Siddhartha-1234/ADC-Analog-Design-ASIC/README.md

# Flash ADC in XSCHEM
* LvtNot -  Inverter which works on low voltage nmos and pmos
* OneHotMux - If else statement or MUX switch
