Siddhartha-1234/ADC-Analog-Design-ASIC/cdac3_v1.png

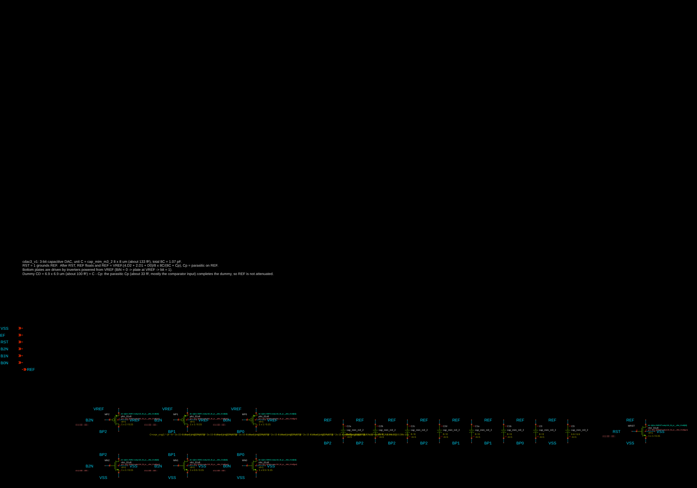
cdac3_v1.png
