Siddhartha-1234/ADC-Analog-Design-ASIC/cdac_vcm3.png

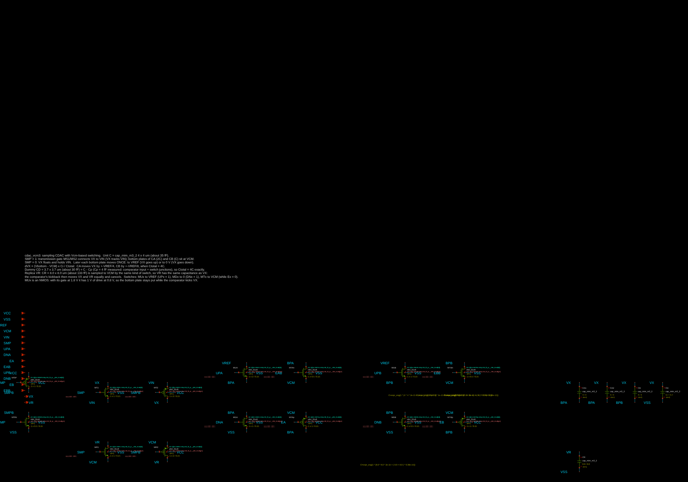
cdac_vcm3.png
