Siddhartha-1234/ADC-Analog-Design-ASIC/inv_min.png

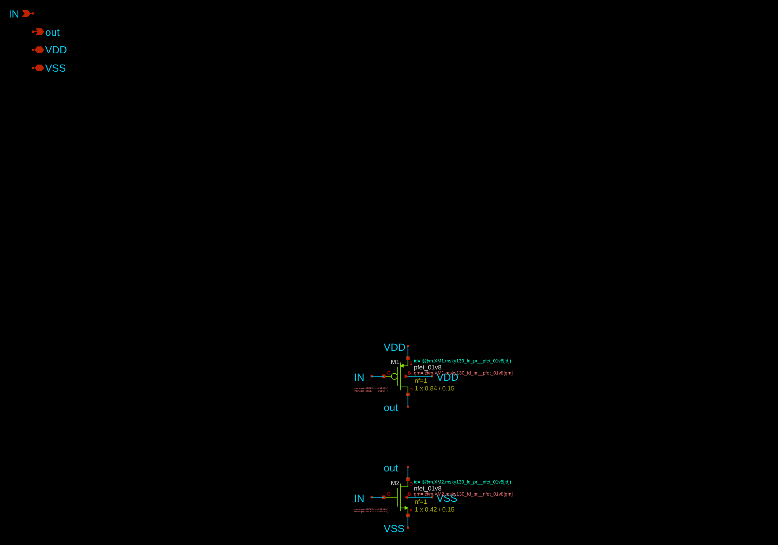
inv_min.png
