Siddhartha-1234/ADC-Analog-Design-ASIC/latch_comp.png

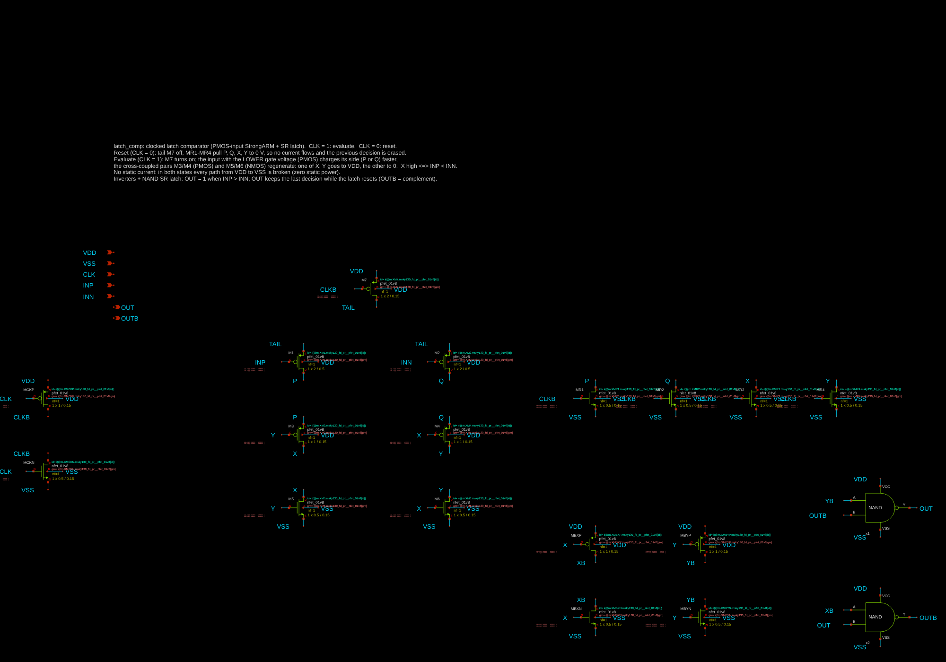
latch_comp.png
