Siddhartha-1234/ADC-Analog-Design-ASIC/nor2_min.png

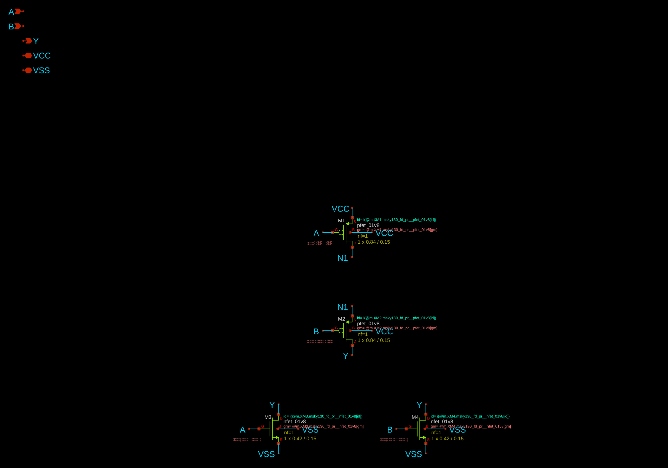
nor2_min.png
