Siddhartha-1234/ADC-Analog-Design-ASIC/sar_adc3_v1.png

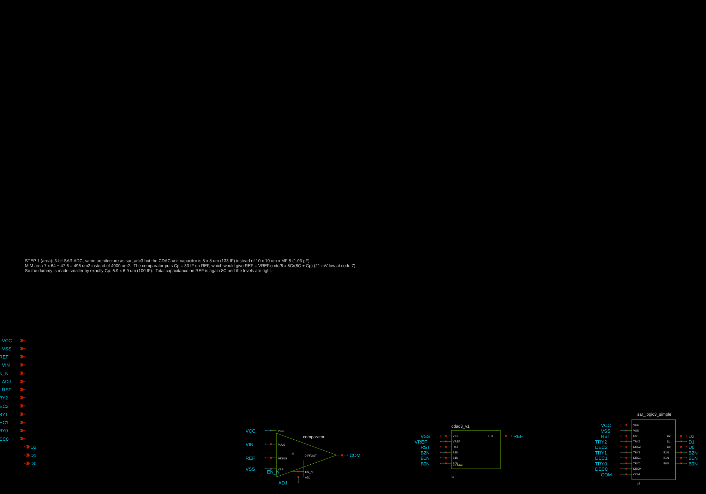
sar_adc3_v1.png
