Siddhartha-1234/ADC-Analog-Design-ASIC/SAR_improved/ramp_dnl_inl/sar_improved_dnl_inl.png

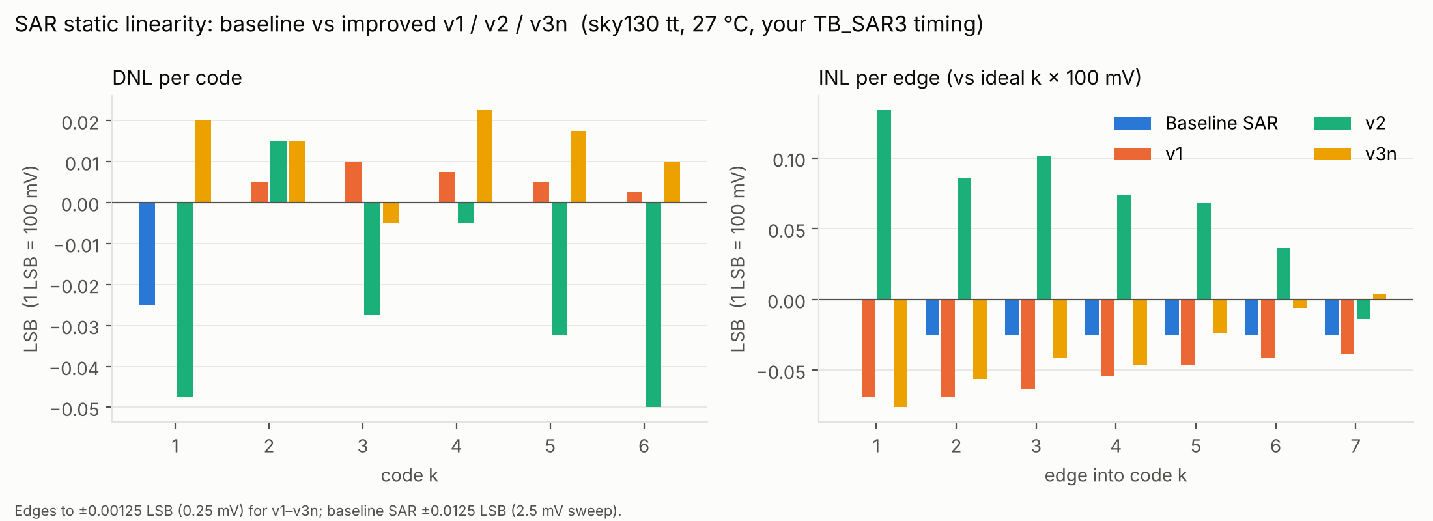
SAR_improved/ramp_dnl_inl/sar_improved_dnl_inl.png
