Siddhartha-1234/ADC-Analog-Design-ASIC/sar_logic_vcm3.png

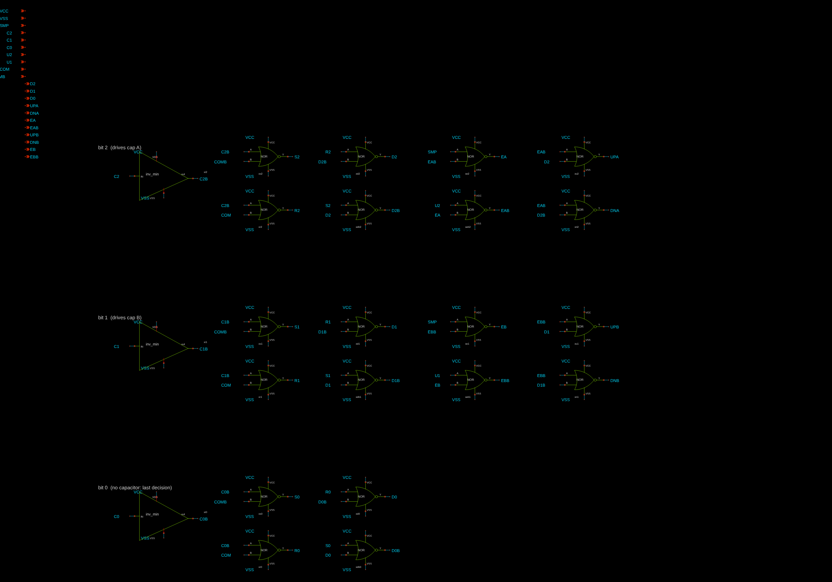
sar_logic_vcm3.png
