Siddhartha-1234/ADC-Analog-Design-ASIC/TB_latch_comp.png

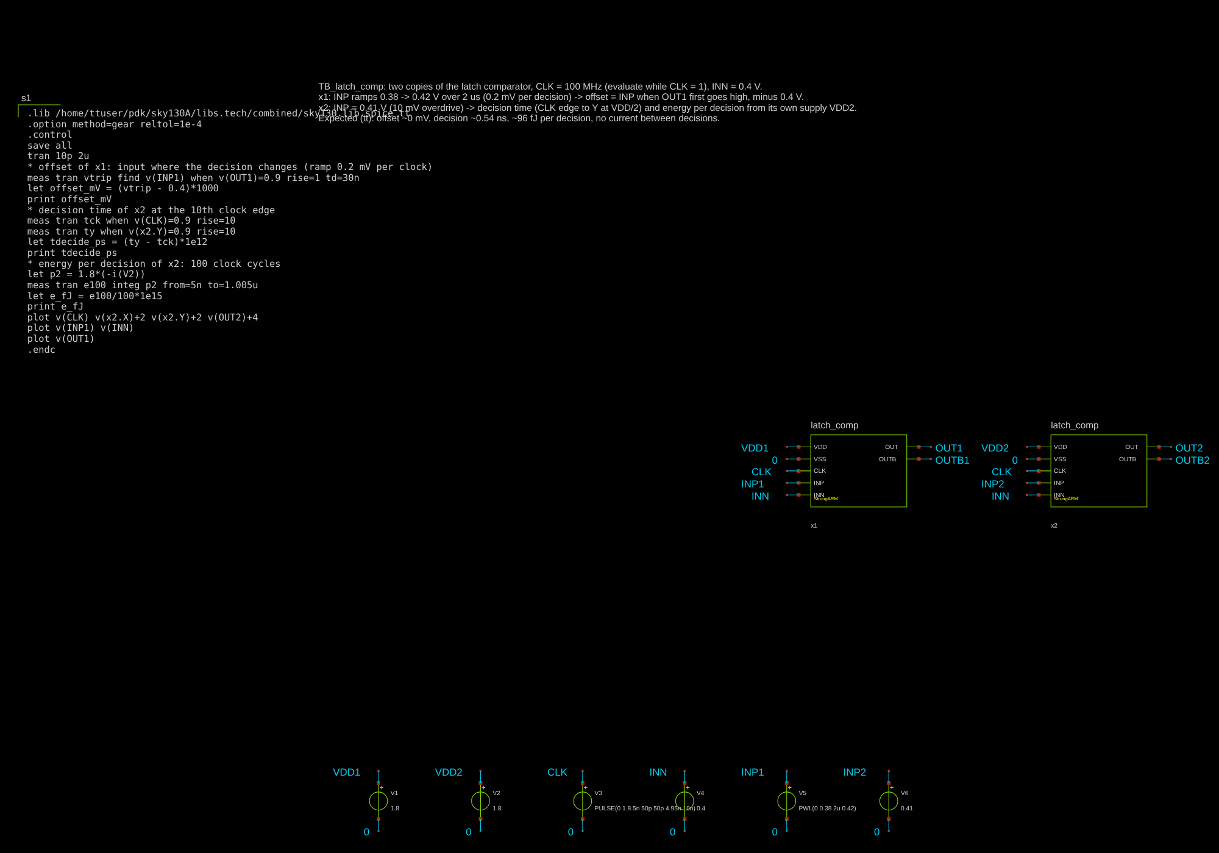
TB_latch_comp.png
