Siddhartha-1234/ADC-Analog-Design-ASIC/TB_SAR3_v3.png

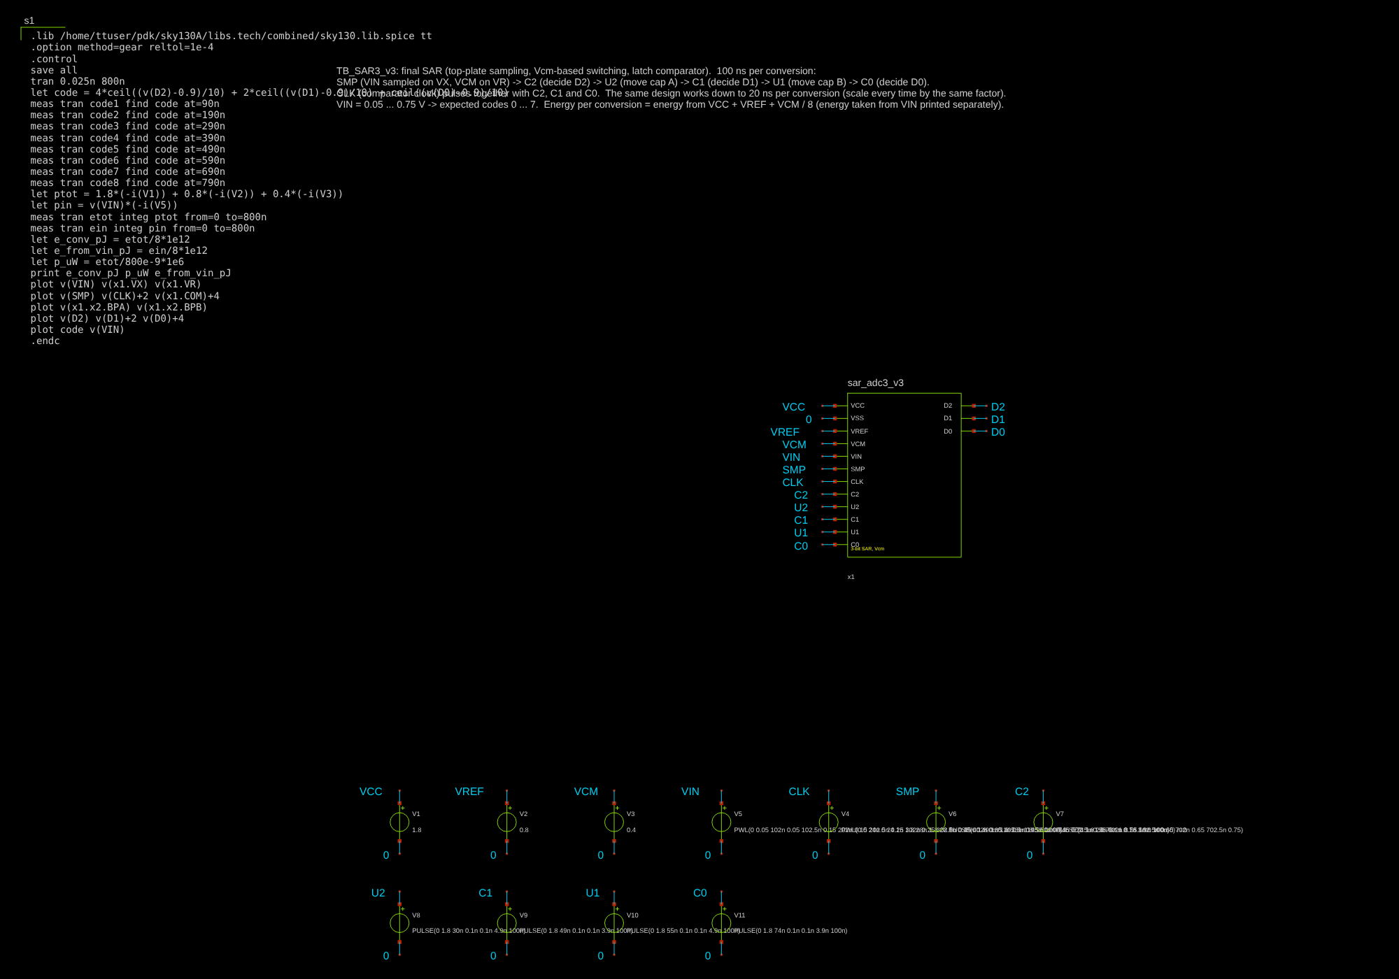
TB_SAR3_v3.png
