Siddhartha-1234/ADC-Analog-Design-ASIC/baseline_measurements/adc_subs.spice

.subckt sar_adc3 VCC VSS VREF VIN EN_N ADJ RST TRY2 DEC2 TRY1 DEC1 TRY0 DEC0 D2 D1 D0
*.ipin VCC
*.ipin VSS
*.ipin VREF
*.ipin VIN
*.ipin EN_N
*.ipin ADJ
*.ipin RST
*.ipin TRY2
*.ipin DEC2
*.ipin TRY1
*.ipin DEC1
*.ipin TRY0
*.ipin DEC0
*.opin D2
*.opin D1
*.opin D0
x1 VCC VSS EN_N REF VIN ADJ COM comparator
x2 VSS VREF RST B2N B1N B0N REF cdac3
x4 VCC VSS RST TRY2 DEC2 TRY1 DEC1 TRY0 DEC0 COM D2 D1 D0 B2N B1N B0N sar_logic3_simple
.ends

.subckt comparator VCC VSS EN_N MINUS PLUS ADJ DIFFOUT
*.ipin VCC
*.ipin VSS
*.ipin EN_N
*.ipin MINUS
*.ipin PLUS
*.ipin ADJ
*.opin DIFFOUT
XM3 net1 EN_N VCC VCC sky130_fd_pr__pfet_01v8 L=8 W=1 nf=1 ad='int((nf+1)/2) * W/nf * 0.29' as='int((nf+2)/2) * W/nf * 0.29'
+ pd='2*int((nf+1)/2) * (W/nf + 0.29)' ps='2*int((nf+2)/2) * (W/nf + 0.29)' nrd='0.29 / W' nrs='0.29 / W'
+ sa=0 sb=0 sd=0 mult=1 m=1
XM7 Inhigh EN_N VCC VCC sky130_fd_pr__pfet_01v8 L=8 W=2 nf=1 ad='int((nf+1)/2) * W/nf * 0.29' as='int((nf+2)/2) * W/nf * 0.29'
+ pd='2*int((nf+1)/2) * (W/nf + 0.29)' ps='2*int((nf+2)/2) * (W/nf + 0.29)' nrd='0.29 / W' nrs='0.29 / W'
+ sa=0 sb=0 sd=0 mult=1 m=1
XM16 mirhigh EN_N VCC VCC sky130_fd_pr__pfet_01v8 L=0.15 W=5 nf=1 ad='int((nf+1)/2) * W/nf * 0.29' as='int((nf+2)/2) * W/nf * 0.29'
+ pd='2*int((nf+1)/2) * (W/nf + 0.29)' ps='2*int((nf+2)/2) * (W/nf + 0.29)' nrd='0.29 / W' nrs='0.29 / W'
+ sa=0 sb=0 sd=0 mult=1 m=1
XM4 G1 ADJ net1 VCC sky130_fd_pr__pfet_01v8_lvt L=1 W=1 nf=1 ad='int((nf+1)/2) * W/nf * 0.29' as='int((nf+2)/2) * W/nf * 0.29'
+ pd='2*int((nf+1)/2) * (W/nf + 0.29)' ps='2*int((nf+2)/2) * (W/nf + 0.29)' nrd='0.29 / W' nrs='0.29 / W'
+ sa=0 sb=0 sd=0 mult=1 m=1
XM5 G1 ADJ net2 VSS sky130_fd_pr__nfet_01v8_lvt L=1 W=0.5 nf=1 ad='int((nf+1)/2) * W/nf * 0.29' as='int((nf+2)/2) * W/nf * 0.29'
+ pd='2*int((nf+1)/2) * (W/nf + 0.29)' ps='2*int((nf+2)/2) * (W/nf + 0.29)' nrd='0.29 / W' nrs='0.29 / W'
+ sa=0 sb=0 sd=0 mult=1 m=1
XM6 net2 VCC VSS VSS sky130_fd_pr__nfet_01v8_lvt L=8 W=0.5 nf=1 ad='int((nf+1)/2) * W/nf * 0.29' as='int((nf+2)/2) * W/nf * 0.29'
+ pd='2*int((nf+1)/2) * (W/nf + 0.29)' ps='2*int((nf+2)/2) * (W/nf + 0.29)' nrd='0.29 / W' nrs='0.29 / W'
+ sa=0 sb=0 sd=0 mult=1 m=1
XM9 G1 MINUS Inhigh VCC sky130_fd_pr__pfet_01v8_lvt L=2 W=8 nf=1 ad='int((nf+1)/2) * W/nf * 0.29' as='int((nf+2)/2) * W/nf * 0.29'
+ pd='2*int((nf+1)/2) * (W/nf + 0.29)' ps='2*int((nf+2)/2) * (W/nf + 0.29)' nrd='0.29 / W' nrs='0.29 / W'
+ sa=0 sb=0 sd=0 mult=1 m=1
XM8 G2 PLUS Inhigh VCC sky130_fd_pr__pfet_01v8_lvt L=2 W=8 nf=1 ad='int((nf+1)/2) * W/nf * 0.29' as='int((nf+2)/2) * W/nf * 0.29'
+ pd='2*int((nf+1)/2) * (W/nf + 0.29)' ps='2*int((nf+2)/2) * (W/nf + 0.29)' nrd='0.29 / W' nrs='0.29 / W'
+ sa=0 sb=0 sd=0 mult=1 m=1
XM11 G2 G2 VSS VSS sky130_fd_pr__nfet_01v8_lvt L=4 W=2 nf=1 ad='int((nf+1)/2) * W/nf * 0.29' as='int((nf+2)/2) * W/nf * 0.29'
+ pd='2*int((nf+1)/2) * (W/nf + 0.29)' ps='2*int((nf+2)/2) * (W/nf + 0.29)' nrd='0.29 / W' nrs='0.29 / W'
+ sa=0 sb=0 sd=0 mult=1 m=1
XM10 G1 G1 VSS VSS sky130_fd_pr__nfet_01v8_lvt L=4 W=2 nf=1 ad='int((nf+1)/2) * W/nf * 0.29' as='int((nf+2)/2) * W/nf * 0.29'
+ pd='2*int((nf+1)/2) * (W/nf + 0.29)' ps='2*int((nf+2)/2) * (W/nf + 0.29)' nrd='0.29 / W' nrs='0.29 / W'
+ sa=0 sb=0 sd=0 mult=1 m=1
XM12 DIFFOUT G2 VSS VSS sky130_fd_pr__nfet_01v8_lvt L=4 W=2 nf=1 ad='int((nf+1)/2) * W/nf * 0.29' as='int((nf+2)/2) * W/nf * 0.29'
+ pd='2*int((nf+1)/2) * (W/nf + 0.29)' ps='2*int((nf+2)/2) * (W/nf + 0.29)' nrd='0.29 / W' nrs='0.29 / W'
+ sa=0 sb=0 sd=0 mult=1 m=1
XM13 DIFFOUT EN_N VSS VSS sky130_fd_pr__nfet_01v8_lvt L=0.15 W=1 nf=1 ad='int((nf+1)/2) * W/nf * 0.29'
+ as='int((nf+2)/2) * W/nf * 0.29' pd='2*int((nf+1)/2) * (W/nf + 0.29)' ps='2*int((nf+2)/2) * (W/nf + 0.29)'
+ nrd='0.29 / W' nrs='0.29 / W' sa=0 sb=0 sd=0 mult=1 m=1
XM17 pg2g G1 VSS VSS sky130_fd_pr__nfet_01v8_lvt L=4 W=2 nf=1 ad='int((nf+1)/2) * W/nf * 0.29' as='int((nf+2)/2) * W/nf * 0.29'
+ pd='2*int((nf+1)/2) * (W/nf + 0.29)' ps='2*int((nf+2)/2) * (W/nf + 0.29)' nrd='0.29 / W' nrs='0.29 / W'
+ sa=0 sb=0 sd=0 mult=1 m=1
XM15 pg2g pg2g mirhigh VCC sky130_fd_pr__pfet_01v8_lvt L=4 W=4 nf=1 ad='int((nf+1)/2) * W/nf * 0.29'
+ as='int((nf+2)/2) * W/nf * 0.29' pd='2*int((nf+1)/2) * (W/nf + 0.29)' ps='2*int((nf+2)/2) * (W/nf + 0.29)'
+ nrd='0.29 / W' nrs='0.29 / W' sa=0 sb=0 sd=0 mult=1 m=1
XM2 DIFFOUT pg2g mirhigh VCC sky130_fd_pr__pfet_01v8_lvt L=4 W=4 nf=1 ad='int((nf+1)/2) * W/nf * 0.29'
+ as='int((nf+2)/2) * W/nf * 0.29' pd='2*int((nf+1)/2) * (W/nf + 0.29)' ps='2*int((nf+2)/2) * (W/nf + 0.29)'
+ nrd='0.29 / W' nrs='0.29 / W' sa=0 sb=0 sd=0 mult=1 m=1
.ends

.subckt cdac3 VSS VREF RST B2N B1N B0N REF
*.ipin VSS
*.ipin VREF
*.ipin RST
*.ipin B2N
*.ipin B1N
*.ipin B0N
*.opin REF
XM1 BP2 B2N VREF VREF sky130_fd_pr__pfet_01v8 L=0.15 W=8 nf=1 ad='int((nf+1)/2) * W/nf * 0.29' as='int((nf+2)/2) * W/nf * 0.29'
+ pd='2*int((nf+1)/2) * (W/nf + 0.29)' ps='2*int((nf+2)/2) * (W/nf + 0.29)' nrd='0.29 / W' nrs='0.29 / W'
+ sa=0 sb=0 sd=0 mult=1 m=1
XM2 BP2 B2N VSS VSS sky130_fd_pr__nfet_01v8 L=0.15 W=4 nf=1 ad='int((nf+1)/2) * W/nf * 0.29' as='int((nf+2)/2) * W/nf * 0.29'
+ pd='2*int((nf+1)/2) * (W/nf + 0.29)' ps='2*int((nf+2)/2) * (W/nf + 0.29)' nrd='0.29 / W' nrs='0.29 / W'
+ sa=0 sb=0 sd=0 mult=1 m=1
XM3 BP1 B1N VREF VREF sky130_fd_pr__pfet_01v8 L=0.15 W=4 nf=1 ad='int((nf+1)/2) * W/nf * 0.29' as='int((nf+2)/2) * W/nf * 0.29'
+ pd='2*int((nf+1)/2) * (W/nf + 0.29)' ps='2*int((nf+2)/2) * (W/nf + 0.29)' nrd='0.29 / W' nrs='0.29 / W'
+ sa=0 sb=0 sd=0 mult=1 m=1
XM4 BP1 B1N VSS VSS sky130_fd_pr__nfet_01v8 L=0.15 W=2 nf=1 ad='int((nf+1)/2) * W/nf * 0.29' as='int((nf+2)/2) * W/nf * 0.29'
+ pd='2*int((nf+1)/2) * (W/nf + 0.29)' ps='2*int((nf+2)/2) * (W/nf + 0.29)' nrd='0.29 / W' nrs='0.29 / W'
+ sa=0 sb=0 sd=0 mult=1 m=1
XM5 BP0 B0N VREF VREF sky130_fd_pr__pfet_01v8 L=0.15 W=2 nf=1 ad='int((nf+1)/2) * W/nf * 0.29' as='int((nf+2)/2) * W/nf * 0.29'
+ pd='2*int((nf+1)/2) * (W/nf + 0.29)' ps='2*int((nf+2)/2) * (W/nf + 0.29)' nrd='0.29 / W' nrs='0.29 / W'
+ sa=0 sb=0 sd=0 mult=1 m=1
XM6 BP0 B0N VSS VSS sky130_fd_pr__nfet_01v8 L=0.15 W=1 nf=1 ad='int((nf+1)/2) * W/nf * 0.29' as='int((nf+2)/2) * W/nf * 0.29'
+ pd='2*int((nf+1)/2) * (W/nf + 0.29)' ps='2*int((nf+2)/2) * (W/nf + 0.29)' nrd='0.29 / W' nrs='0.29 / W'
+ sa=0 sb=0 sd=0 mult=1 m=1
XC2a REF BP2 sky130_fd_pr__cap_mim_m3_2 W=10 L=10 MF=5 m=5
XC2b REF BP2 sky130_fd_pr__cap_mim_m3_2 W=10 L=10 MF=5 m=5
XC2c REF BP2 sky130_fd_pr__cap_mim_m3_2 W=10 L=10 MF=5 m=5
XC2d REF BP2 sky130_fd_pr__cap_mim_m3_2 W=10 L=10 MF=5 m=5
XC1a REF BP1 sky130_fd_pr__cap_mim_m3_2 W=10 L=10 MF=5 m=5
XC1b REF BP1 sky130_fd_pr__cap_mim_m3_2 W=10 L=10 MF=5 m=5
XC0a REF BP0 sky130_fd_pr__cap_mim_m3_2 W=10 L=10 MF=5 m=5
XCD REF VSS sky130_fd_pr__cap_mim_m3_2 W=10 L=10 MF=5 m=5
XM7 REF RST VSS VSS sky130_fd_pr__nfet_01v8 L=0.15 W=1 nf=1 ad='int((nf+1)/2) * W/nf * 0.29' as='int((nf+2)/2) * W/nf * 0.29'
+ pd='2*int((nf+1)/2) * (W/nf + 0.29)' ps='2*int((nf+2)/2) * (W/nf + 0.29)' nrd='0.29 / W' nrs='0.29 / W'
+ sa=0 sb=0 sd=0 mult=1 m=1
.ends

.subckt sar_logic3_simple VCC VSS RST TRY2 DEC2 TRY1 DEC1 TRY0 DEC0 COM D2 D1 D0 B2N B1N B0N
*.ipin VCC
*.ipin VSS
*.ipin RST
*.ipin TRY2
*.ipin DEC2
*.ipin TRY1
*.ipin DEC1
*.ipin TRY0
*.ipin DEC0
*.ipin COM
*.opin D2
*.opin D1
*.opin D0
*.opin B2N
*.opin B1N
*.opin B0N
x1 VCC RST RSTB VSS inverter
x2 VCC COM COMB VSS inverter
x3 DEC2 COMB K2 VCC VSS nand2
x4 RSTB K2 R2 VCC VSS nand2
x5 R2 B2N D2 VCC VSS nor2
x6 TRY2 D2 B2N VCC VSS nor2
x7 DEC1 COMB K1 VCC VSS nand2
x8 RSTB K1 R1 VCC VSS nand2
x9 R1 B1N D1 VCC VSS nor2
x10 TRY1 D1 B1N VCC VSS nor2
x11 DEC0 COMB K0 VCC VSS nand2
x12 RSTB K0 R0 VCC VSS nand2
x13 R0 B0N D0 VCC VSS nor2
x14 TRY0 D0 B0N VCC VSS nor2
.ends

.subckt inverter VDD IN out VSS
*.ipin IN
*.opin out
*.iopin VDD
*.iopin VSS
XM3 out IN VDD VDD sky130_fd_pr__pfet_01v8 L=0.15 W=1 nf=1 ad='int((nf+1)/2) * W/nf * 0.29' as='int((nf+2)/2) * W/nf * 0.29'
+ pd='2*int((nf+1)/2) * (W/nf + 0.29)' ps='2*int((nf+2)/2) * (W/nf + 0.29)' nrd='0.29 / W' nrs='0.29 / W'
+ sa=0 sb=0 sd=0 mult=1 m=1
XM2 out IN VSS VSS sky130_fd_pr__nfet_01v8 L=0.15 W=1 nf=1 ad='int((nf+1)/2) * W/nf * 0.29' as='int((nf+2)/2) * W/nf * 0.29'
+ pd='2*int((nf+1)/2) * (W/nf + 0.29)' ps='2*int((nf+2)/2) * (W/nf + 0.29)' nrd='0.29 / W' nrs='0.29 / W'
+ sa=0 sb=0 sd=0 mult=1 m=1
.ends

.subckt nand2 A B Y VCC VSS
*.ipin A
*.ipin B
*.opin Y
*.iopin VCC
*.iopin VSS
XM1 Y A VCC VCC sky130_fd_pr__pfet_01v8 L=0.15 W=2 nf=1 ad='int((nf+1)/2) * W/nf * 0.29' as='int((nf+2)/2) * W/nf * 0.29'
+ pd='2*int((nf+1)/2) * (W/nf + 0.29)' ps='2*int((nf+2)/2) * (W/nf + 0.29)' nrd='0.29 / W' nrs='0.29 / W'
+ sa=0 sb=0 sd=0 mult=1 m=1
XM2 Y B VCC VCC sky130_fd_pr__pfet_01v8 L=0.15 W=2 nf=1 ad='int((nf+1)/2) * W/nf * 0.29' as='int((nf+2)/2) * W/nf * 0.29'
+ pd='2*int((nf+1)/2) * (W/nf + 0.29)' ps='2*int((nf+2)/2) * (W/nf + 0.29)' nrd='0.29 / W' nrs='0.29 / W'
+ sa=0 sb=0 sd=0 mult=1 m=1
XM3 Y A N1 VSS sky130_fd_pr__nfet_01v8 L=0.15 W=2 nf=1 ad='int((nf+1)/2) * W/nf * 0.29' as='int((nf+2)/2) * W/nf * 0.29'
+ pd='2*int((nf+1)/2) * (W/nf + 0.29)' ps='2*int((nf+2)/2) * (W/nf + 0.29)' nrd='0.29 / W' nrs='0.29 / W'
+ sa=0 sb=0 sd=0 mult=1 m=1
XM4 N1 B VSS VSS sky130_fd_pr__nfet_01v8 L=0.15 W=2 nf=1 ad='int((nf+1)/2) * W/nf * 0.29' as='int((nf+2)/2) * W/nf * 0.29'
+ pd='2*int((nf+1)/2) * (W/nf + 0.29)' ps='2*int((nf+2)/2) * (W/nf + 0.29)' nrd='0.29 / W' nrs='0.29 / W'
+ sa=0 sb=0 sd=0 mult=1 m=1
.ends

.subckt nor2 A B Y VCC VSS
*.ipin A
*.ipin B
*.opin Y
*.iopin VCC
*.iopin VSS
XM1 P1 A VCC VCC sky130_fd_pr__pfet_01v8 L=0.15 W=4 nf=1 ad='int((nf+1)/2) * W/nf * 0.29' as='int((nf+2)/2) * W/nf * 0.29'
+ pd='2*int((nf+1)/2) * (W/nf + 0.29)' ps='2*int((nf+2)/2) * (W/nf + 0.29)' nrd='0.29 / W' nrs='0.29 / W'
+ sa=0 sb=0 sd=0 mult=1 m=1
XM2 Y B P1 VCC sky130_fd_pr__pfet_01v8 L=0.15 W=4 nf=1 ad='int((nf+1)/2) * W/nf * 0.29' as='int((nf+2)/2) * W/nf * 0.29'
+ pd='2*int((nf+1)/2) * (W/nf + 0.29)' ps='2*int((nf+2)/2) * (W/nf + 0.29)' nrd='0.29 / W' nrs='0.29 / W'
+ sa=0 sb=0 sd=0 mult=1 m=1
XM3 Y A VSS VSS sky130_fd_pr__nfet_01v8 L=0.15 W=1 nf=1 ad='int((nf+1)/2) * W/nf * 0.29' as='int((nf+2)/2) * W/nf * 0.29'
+ pd='2*int((nf+1)/2) * (W/nf + 0.29)' ps='2*int((nf+2)/2) * (W/nf + 0.29)' nrd='0.29 / W' nrs='0.29 / W'
+ sa=0 sb=0 sd=0 mult=1 m=1
XM4 Y B VSS VSS sky130_fd_pr__nfet_01v8 L=0.15 W=1 nf=1 ad='int((nf+1)/2) * W/nf * 0.29' as='int((nf+2)/2) * W/nf * 0.29'
+ pd='2*int((nf+1)/2) * (W/nf + 0.29)' ps='2*int((nf+2)/2) * (W/nf + 0.29)' nrd='0.29 / W' nrs='0.29 / W'
+ sa=0 sb=0 sd=0 mult=1 m=1
.ends

.subckt flash_adc3 VCC VSS VREF VIN EN_N ADJ D2 D1 D0
*.ipin VCC
*.ipin VSS
*.ipin VREF
*.ipin VIN
*.ipin EN_N
*.ipin ADJ
*.opin D2
*.opin D1
*.opin D0
XR8 TAP7 VREF VSS sky130_fd_pr__res_high_po_0p35 L=20 mult=1 m=1
XR7 TAP6 TAP7 VSS sky130_fd_pr__res_high_po_0p35 L=20 mult=1 m=1
XR6 TAP5 TAP6 VSS sky130_fd_pr__res_high_po_0p35 L=20 mult=1 m=1
XR5 TAP4 TAP5 VSS sky130_fd_pr__res_high_po_0p35 L=20 mult=1 m=1
XR4 TAP3 TAP4 VSS sky130_fd_pr__res_high_po_0p35 L=20 mult=1 m=1
XR3 TAP2 TAP3 VSS sky130_fd_pr__res_high_po_0p35 L=20 mult=1 m=1
XR2 TAP1 TAP2 VSS sky130_fd_pr__res_high_po_0p35 L=20 mult=1 m=1
XR1 VSS TAP1 VSS sky130_fd_pr__res_high_po_0p35 L=20 mult=1 m=1
x1 VCC VSS EN_N TAP1 VIN ADJ T1 comparator
x2 VCC VSS EN_N TAP2 VIN ADJ T2 comparator
x3 VCC VSS EN_N TAP3 VIN ADJ T3 comparator
x4 VCC VSS EN_N TAP4 VIN ADJ T4 comparator
x5 VCC VSS EN_N TAP5 VIN ADJ T5 comparator
x6 VCC VSS EN_N TAP6 VIN ADJ T6 comparator
x7 VCC VSS EN_N TAP7 VIN ADJ T7 comparator
x8 VCC VSS T1 T2 T3 T4 T5 T6 T7 D2 D1 D0 therm2bin3
.ends

.subckt therm2bin3 VCC VSS T1 T2 T3 T4 T5 T6 T7 D2 D1 D0
*.ipin VCC
*.ipin VSS
*.ipin T1
*.ipin T2
*.ipin T3
*.ipin T4
*.ipin T5
*.ipin T6
*.ipin T7
*.opin D2
*.opin D1
*.opin D0
XM1 T2B T2 VCC VCC sky130_fd_pr__pfet_01v8 L=0.15 W=2 nf=1 ad='int((nf+1)/2) * W/nf * 0.29' as='int((nf+2)/2) * W/nf * 0.29'
+ pd='2*int((nf+1)/2) * (W/nf + 0.29)' ps='2*int((nf+2)/2) * (W/nf + 0.29)' nrd='0.29 / W' nrs='0.29 / W'
+ sa=0 sb=0 sd=0 mult=1 m=1
XM2 T2B T2 VSS VSS sky130_fd_pr__nfet_01v8 L=0.15 W=1 nf=1 ad='int((nf+1)/2) * W/nf * 0.29' as='int((nf+2)/2) * W/nf * 0.29'
+ pd='2*int((nf+1)/2) * (W/nf + 0.29)' ps='2*int((nf+2)/2) * (W/nf + 0.29)' nrd='0.29 / W' nrs='0.29 / W'
+ sa=0 sb=0 sd=0 mult=1 m=1
XM3 T4B T4 VCC VCC sky130_fd_pr__pfet_01v8 L=0.15 W=2 nf=1 ad='int((nf+1)/2) * W/nf * 0.29' as='int((nf+2)/2) * W/nf * 0.29'
+ pd='2*int((nf+1)/2) * (W/nf + 0.29)' ps='2*int((nf+2)/2) * (W/nf + 0.29)' nrd='0.29 / W' nrs='0.29 / W'
+ sa=0 sb=0 sd=0 mult=1 m=1
XM4 T4B T4 VSS VSS sky130_fd_pr__nfet_01v8 L=0.15 W=1 nf=1 ad='int((nf+1)/2) * W/nf * 0.29' as='int((nf+2)/2) * W/nf * 0.29'
+ pd='2*int((nf+1)/2) * (W/nf + 0.29)' ps='2*int((nf+2)/2) * (W/nf + 0.29)' nrd='0.29 / W' nrs='0.29 / W'
+ sa=0 sb=0 sd=0 mult=1 m=1
XM5 T6B T6 VCC VCC sky130_fd_pr__pfet_01v8 L=0.15 W=2 nf=1 ad='int((nf+1)/2) * W/nf * 0.29' as='int((nf+2)/2) * W/nf * 0.29'
+ pd='2*int((nf+1)/2) * (W/nf + 0.29)' ps='2*int((nf+2)/2) * (W/nf + 0.29)' nrd='0.29 / W' nrs='0.29 / W'
+ sa=0 sb=0 sd=0 mult=1 m=1
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
+ sa=0 sb=0 sd=0 mult=1 m=1
XM33 D0 N3 VCC VCC sky130_fd_pr__pfet_01v8 L=0.15 W=2 nf=1 ad='int((nf+1)/2) * W/nf * 0.29' as='int((nf+2)/2) * W/nf * 0.29'
+ pd='2*int((nf+1)/2) * (W/nf + 0.29)' ps='2*int((nf+2)/2) * (W/nf + 0.29)' nrd='0.29 / W' nrs='0.29 / W'
+ sa=0 sb=0 sd=0 mult=1 m=1
XM34 D0 T7B VCC VCC sky130_fd_pr__pfet_01v8 L=0.15 W=2 nf=1 ad='int((nf+1)/2) * W/nf * 0.29' as='int((nf+2)/2) * W/nf * 0.29'
+ pd='2*int((nf+1)/2) * (W/nf + 0.29)' ps='2*int((nf+2)/2) * (W/nf + 0.29)' nrd='0.29 / W' nrs='0.29 / W'
+ sa=0 sb=0 sd=0 mult=1 m=1
XM35 D0 N1 D0_n1 VSS sky130_fd_pr__nfet_01v8 L=0.15 W=4 nf=1 ad='int((nf+1)/2) * W/nf * 0.29' as='int((nf+2)/2) * W/nf * 0.29'
+ pd='2*int((nf+1)/2) * (W/nf + 0.29)' ps='2*int((nf+2)/2) * (W/nf + 0.29)' nrd='0.29 / W' nrs='0.29 / W'
+ sa=0 sb=0 sd=0 mult=1 m=1
XM36 D0_n1 N2 D0_n2 VSS sky130_fd_pr__nfet_01v8 L=0.15 W=4 nf=1 ad='int((nf+1)/2) * W/nf * 0.29' as='int((nf+2)/2) * W/nf * 0.29'
+ pd='2*int((nf+1)/2) * (W/nf + 0.29)' ps='2*int((nf+2)/2) * (W/nf + 0.29)' nrd='0.29 / W' nrs='0.29 / W'
+ sa=0 sb=0 sd=0 mult=1 m=1
XM37 D0_n2 N3 D0_n3 VSS sky130_fd_pr__nfet_01v8 L=0.15 W=4 nf=1 ad='int((nf+1)/2) * W/nf * 0.29' as='int((nf+2)/2) * W/nf * 0.29'
+ pd='2*int((nf+1)/2) * (W/nf + 0.29)' ps='2*int((nf+2)/2) * (W/nf + 0.29)' nrd='0.29 / W' nrs='0.29 / W'
+ sa=0 sb=0 sd=0 mult=1 m=1
XM38 D0_n3 T7B VSS VSS sky130_fd_pr__nfet_01v8 L=0.15 W=4 nf=1 ad='int((nf+1)/2) * W/nf * 0.29' as='int((nf+2)/2) * W/nf * 0.29'
+ pd='2*int((nf+1)/2) * (W/nf + 0.29)' ps='2*int((nf+2)/2) * (W/nf + 0.29)' nrd='0.29 / W' nrs='0.29 / W'
+ sa=0 sb=0 sd=0 mult=1 m=1
.ends
