Siddhartha-1234/ADC-Analog-Design-ASIC/(commit log)

2026-08-02 Adding a mixer block
    [mixer.sch, mosfet.sch]
2026-08-04 Corrected the Symbol
    [mixer.sch]
2026-08-05 Comparator added
    [comparator.sch]
2026-08-06 low voltage fets added in required place and corrected W and L values for all
    [comparator.sch]
2026-08-07 Revert "low voltage fets added in required place and corrected W and L values for all"
    This reverts commit 8ea57666e7bf7a7c070890f9858512e226a6f145.
    [comparator.sch]
2026-08-07 corrected symbol for comparator
    [comparator.sch]
2026-08-08 analog switch added
    [analogSwitch.sch, lvtNOT.sch, untitled.sch]
2026-08-10 One hot mux added
    [onehot2mux.sch]
2026-08-11 Calibrated comparator made
    [Calibrated_comparator.sch, onehot2mux.sch]
2026-08-12 Calibration of comparator done
    [Calibrated_comparator.sch]
2026-08-13 Created Symbol for calibrated comparator and fixed design issue
    [Calibrated_comparator.sch]
2026-08-15 Calibrated comparator symbol mux added
2026-08-16 Resistor chain added and adc block build
    [ADC_Block.sch, r2r.sch]
2026-08-17 README and testbench for ADC created
    [Tb_ADC.sch]
2026-08-18 Tb for comparator made
    [TB_Comparator.sch]
2026-08-19 Low voltage Not gate added
    [TB_lvtNot.sch]
2026-08-20 low voltage not gate corrections done
2026-08-21 Inverter file made and testbench partially made
    [inverter.sch, tb_inverter.sch]
2026-08-25 Testbench tested for rlc circuit
2026-10-25 SAR and Flash ADC completed along with shift add mechanish for CiM
2026-11-11 6 bit SAR ADC
